ajeddeloh/lmeter/(commit log)

2020-05-21 STM32CubeL4: add submodule at tag v1.15.1
2020-06-14 interrupts: add systick interrupt
    Add a systick interrupt handler so it's not handled by the
    DefaultHandler which loops forever. Bonus: things that depend on SysTick
    in the HAL libraries should work too.
2020-06-14 startup: Add our own copy of the startup file
    Move the iPSR into R0 in the DefaultHandler so I can see where
    interrupts come from. Seems like openocd/gdb should expose this but they
    dont?
2020-06-14 main: add simple POC code for confirming GPIO/UART
    Add simple code that justs ensures we have the uart and gpio working
    correctly.
    [main.c]
2020-06-14 src: break uart into it's own file
2020-06-15 clock: set up clock to be 80MHz
    Set up the clock to run at 80MHz. Use the HSE oscillator at 8MHz with
    the PLL set up to give x10.
    Note solder bridge 18 needs to be closed and 22 needs to opened.
    [clock.c, main.c]
2020-06-22 adc: add adc code to setup ADC1
    Set up ADC1 to operate:
    - At 4.21MSPS (6.5 sampling + 12.5 conversion cycles at 80MHz)
    - In differential mode
    - With an offset of 2048 so the difference is reported as a signed
    number.
    - Using DMA (DMA1)
    - Hooked up to PA1 and PA2 as +/-
    Ideally we'd use the PC0/PC1 pins since they can reach 5.33Msps but on
    the stm32l476G-Discovery board those pins are not accessible. Oh well,
    4.21Msps is fine.
    Some interrupts are currently enabled that I may not want to be enabled
    later, mostly for debugging. They aren't used for anything right now.
2020-06-22 Makefile: turn on better debugging
    Enable better debugging so gdb can use #defines from the stm32l476xx.h
    header.
2020-06-23 adc: minor cleanup, switch up the pins
    Use PA0, PA1 for ADC1 with plans for PA2, PA3 for ADC2 in the future.
2020-06-23 adc: make adcs run together
    Configure the adc to run together in simulataneous regular mode
2020-06-25 dac: get dac working, output a sine
    - Hook up DAC channel 2 to TIM6 and DMA2 to update every 19 cycles
    (same rate as the ADC, we should have the clocks synced)
    - output a sine waveform
    - Note on the STM32L476G-Discovery board I needed to remove: R52, R54,
    R56, R58, R55 and C43. These were the pulldowns for the joystick but
    they interfere with the DAC output.
    [dac.c, main.c, sine.h]
2020-06-26 adc: make do_capture return result, reinit dma
    Change do_capture to return the buffer. Also reinit the dma so it
    actually captures each time it's run.
2020-06-26 adc: fix clock, sampling time
    - Fix typo setting ADC clock to HCLK/4 instead of HCLK
    - Fix ADC sampling time to configure the correct channels
    [adc.c]
2020-06-26 plotdat.py: add help for plotting data
    It's frequently useful to inspect the data from the ADC. Write a short
    script to plot data dumps (including doing the deinterlacing). See
    comments in the script for usage.
    [plotdat.py]
2020-07-02 hardware: add kicad project and pdf of schematic
    Add a kicad project to document how the hardware is set up.
    [lmeter.kicad_pcb, lmeter.sch]
2020-07-03 sine: rework to have an array of possible sines
    Rework to have an array of possible sines to select from. Add a struct
    for the sines as well.
    Also comment and tidy up a few bits.
    [dac.c, main.c, sine.c, sine.h]
2020-07-03 bit_band,adc: add bit-banding marco, use it
    Add a macro for helping with bit-banding. Use it to toggle the DMA
    on/off when using the ADC.
2020-07-03 sines: use sine waves from ~10.5kHz to ~21kHz
    Use lower frequency sine waves to reduce any effects from parasitic
    capacitance.
2020-07-04 main,adc: always capture a whole number of cycles
    Set the capture length such that we always capture an integer number of
    cycles. Also make the data array volatile, as it should be.
2020-07-06 Makefile: enable hard floating float
    Emit hardware floating point instructions. Change all constants to be
    floats instead of doubles, since the cortex-m4 doesn't have hardware
    double support.
    [main.c]
2020-07-10 adc: use volatile where needed
2020-07-23 *: use correct buffer lengths
    In order to prevent windowing issues we always sample a whole number of
    cycles. This means sometimes we don't quite fill up the whole buffer.
    Only use the data we wrote when doing calculations.
    [main.c, plotdat.py]
2020-07-24 sine: use high res cos/sin for calculations
    Use sin/cos with 20 bit resolution for calculations. These are
    multiplied with the results from the ADC which are 12 bit, giving a max
    value that just barely fits in 32 bits.
    Additionally, print values in scientific notation.
2020-07-29 dac: change sines smoothly
    Change sine frequency seamlessly. Wait until we're at the end of the
    sine to switch to the new sine. This prevents sharp transitions between
    sines.
    [dac.c]
2020-07-29 main: sweep down in frequency after hitting max
    Instead of sweeping up to the max frequency then jumping down to the
    start, sweep back down to prevent sharp transitions.
    [main.c]
2020-08-01 *: allow for arbitarily long adc captures
    Instead of capturing data into a buffer then processing it, process the
    data as it comes. Since we're just calculating the DFT at one frequency
    we can just accumulate the products of f(x) and e^(iwf) as we get data.
    This has two main advantages:
    1) We can capture more data than would fit in RAM, improving precision.
    2) We free up the 64k of ram used to the ADC buffer. This could be used
    to store sin/cos tables so they only need to be calculated once.
    Since the ADC is running at 60 cycles/sample we need to process the data
    at least that fast. Use a second lookup table for cos instead of using
    an offset into the sine. Since ADC data arrives 4x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
2020-08-01 sine: precalculate all sine waves
    Now that the ADC isn't consuming 64k of ram for it's buffers, we can
    precompute all the sine waves. Make each ADC capture shorter so we only
    need to store 1 wave in the high res lookup tables, not 4.
    [adc.c, main.c, sine.c, sine.h]
2020-08-02 hardware: remove 1.5k resistors
    Remove the 1.5k resistors between the op amp outputs and ADC inputs.
    While the datasheets say they should be fine, they lead to small amounts
    of error.
    [lmeter.sch]
